wagiminator/ATtiny13-TinyMoisture/hardware/TinyMoisture_BOM.tsv

ID | Name | Designator | Footprint | Quantity | Manufacturer Part | Manufacturer | Supplier | Supplier Part | LCSC Assembly
1 | MMBT3904 | Q2 | SOT-23_1 | 1 | MMBT3904 | CJ | LCSC | C20526
2 | MLT-5030 | BUZZER1 | MLT-5030 | 1 | MLT-5030 | HNDZ | LCSC | C95297
3 | 1k | R6,R5 | 0603 | 2 | 0603WAF1001T5E | UniOhm | LCSC | C21190
4 | 10k | R2,R1 | 0603 | 2 | 0603WAF1002T5E | UniOhm | LCSC | C25804
5 | 100R | R3 | 0603 | 1 | 0603WAF1000T5E | UniOhm | LCSC | C22775
6 | CR2032-BS-6-1 | B1 | BATTERY-3 | 1 | CR2032-BS-6-1 | Q&J | LCSC | C70377
7 | DRY | LED1 | LED0603 | 1 | KT-0603R | KENTO | LCSC | C2286 | Yes
8 | PROBE1 | H1 | HDR-M-2.54_1X1 | 1 |  |  | LCSC | C81276
9 | PROBE2 | H2 | HDR-M-2.54_1X1 | 1 |  |  | LCSC | C81276
10 | ATtiny13A | U6 | SOP-8_150MIL | 1 | ATTINY13A-SSU | MICROCHIP | LCSC | C14075
11 | TEST | KEY1 | KEY-3.0*6.0 | 1 | 3x6x2.5Red head high temperature | ReliaPro | LCSC | C46491
12 | 100n | C1 | 0603 | 1 | CC0603KRX7R9BB104 | YAGEO | LCSC | C14663
13 | 10u | C2 | 0603 | 1 | C0603X5R106M160NT | SANYEAR | LCSC | C466781
14 | 10k | R4 | TC33X | 1 | TC33X-2-103E | BOURNS | LCSC | C719176
15 | MMBT3904 | Q1 | SOT-23-3 | 1 | MMBT3904 | CJ | LCSC | C20526 | Yes
