wagiminator/ATtiny13-TinyMoisture/hardware/TinyMoisture_schematic.pdf

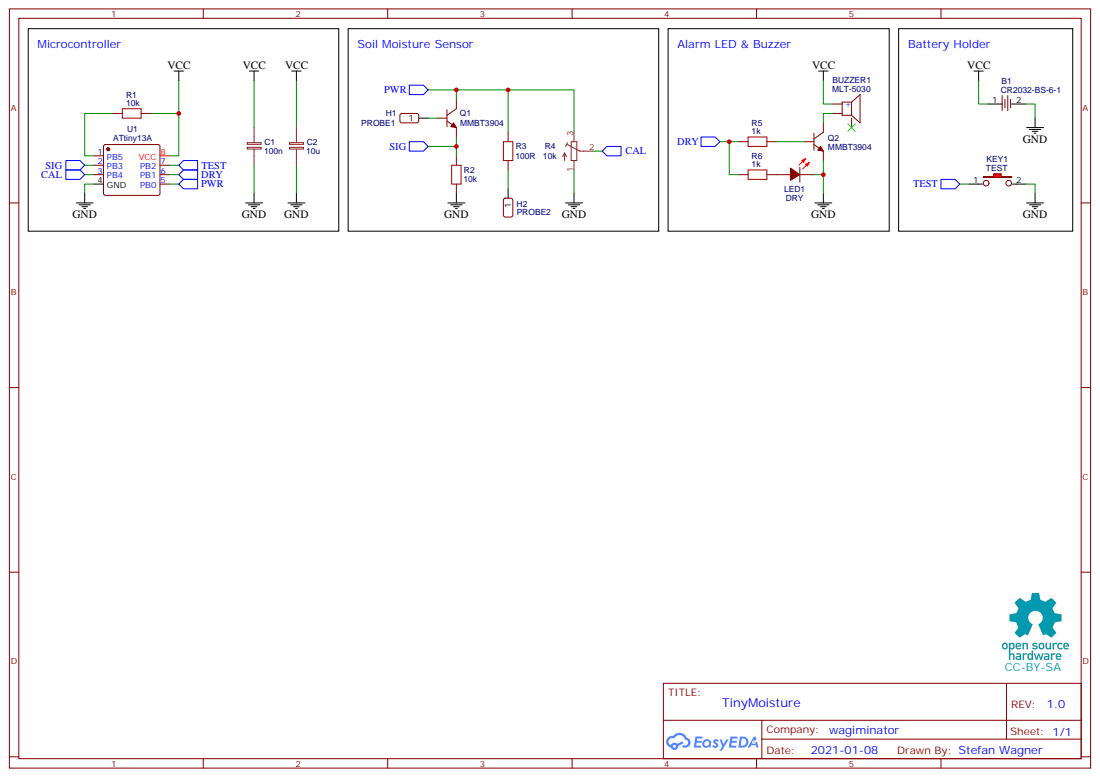
[picture p5: page 1]

Drawn By: Stefan Wagner
